fanxiaohui/SmartCar/PCB资料/鹰眼管脚说明.pdf

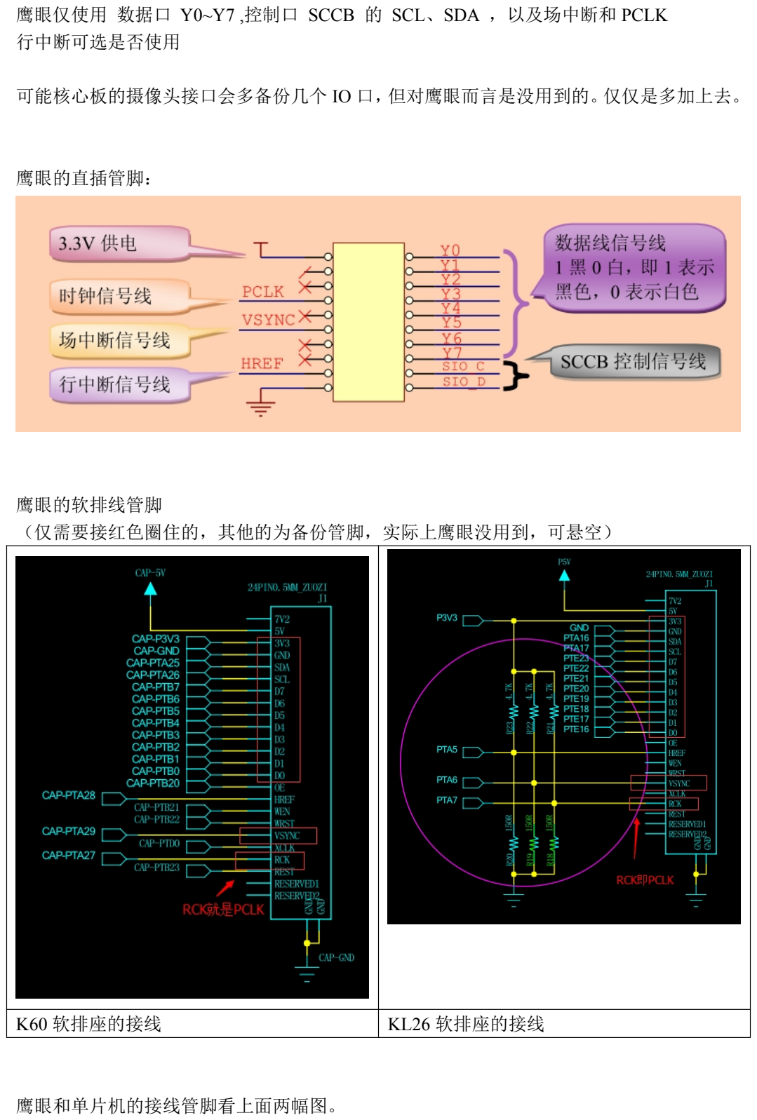
[picture p71: page 1]

鹰眼仅使用 数据口 Y0~Y7 ,控制口 SCCB 的 SCL、SDA ，以及场中断和 PCLK 行中断可选是否使用

可能核心板的摄像头接口会多备份几个 IO 口，但对鹰眼而言是没用到的。仅仅是多加上去。

鹰眼的直插管脚：

鹰眼的软排线管脚
（仅需要接红色圈住的，其他的为备份管脚，实际上鹰眼没用到，可悬空）
K60 软排座的接线 | KL26 软排座的接线

鹰眼和单片机的接线管脚看上面两幅图。
