fanxiaohui/SmartCar/十二届光电追逐组程序（附说明，一点资料）/逆透视变换的一种方法.pdf

# www.znczz.com

# 逆透视变换的一种方法

朱葛峻

2015年12月

## 1 写这篇文章的原因

前段时间有人问了我这篇帖子（[分享] 好久没有人发技术贴了，来个透视变 换与其逆变换的矩阵公式，打打鸡血），文中的方法很有道理，但却很复杂。 (http://www.znczz.com/thread-119033-1-1.html) 于是我想把我的方法写出来。

## 2 数学模型

小孔摄像机数学模型：

s

x
y
1
- =
fx | 0 | cx
0 | fy | cy
0 | 0 | 1
r11 | r12 | r13 | t1
r21 | r22 | r23 | t2
r31 | r32 | r33 | t3

X
Y
Z
1

针对以上模型，我们可以归纳为：

s · m⁰ = A · [R|t] · M⁰

其中s是倍乘因子，m⁰指图像坐标系，M⁰指世界坐标系，[R|t]指线性变换矩 阵，A指相机内参数矩阵。

## 3 对于模型的一点解释

s · m⁰这个就是我们通常程序中对图像的贮存，即获得的二维数组，当然也 有些同学用一维数组表示。也许以后有同学能设计出一个数据结构呢。 A内参数矩阵的意义是，将相机坐标系转换为像平面坐标系，可以这么想 像，将一幅本来存在于芯片镜面上的图像转换为我们脑海里的数组。其实就是 转换坐标系，图像一开始在芯片以毫米英寸为单位，现在转换为以一个像素为 单位了。其实就像可以描述一个人为一米八，也可以描述为为九头身。 [R|t]就是我们所说的线性变换矩阵。关于这里的知识可以访问百度文库里 的这篇演示文档：图像处理之逆透视变换。 (http://wenku.baidu.com/link)
M’就是世界坐标系了。

1

# www.znczz.com

### 4 应用

这个公式源自张正友先生的论文，opencv里也有引用。这里讲下在飞思卡 尔智能车的应用下的方式。
首先，一般智能车选择的是单目摄像头且不存在测距模块，无法获得一副图 像的深度图，那么自然而然，Z=0。

s

x
y
1
- =
fx | 0 | cx
0 | fy | cy
0 | 0 | 1
r11 | r12 | r13 | t1
r21 | r22 | r23 | t2
r31 | r32 | r33 | t3

X
Y
0
1

let H =

fx | 0 | cx
0 | fy | cy
0 | 0 | 1
r11 | r12 | r13 | t1
r21 | r22 | r23 | t2
r31 | r32 | r33 | t3

and H34 =

H11 | H12 | Don⁰
tCare H13
H21 | H22 | Don⁰
tCare H23
H31 | H32 | Don⁰
tCare | 1

又因为H33可以归纳为s的一部分，即可得到最终我们需要的一个表达式。

x
y
s
- =
H11 | H12 | H13
H21 | H22 | H23
H31 | H32 | 1

X
Y
1

### 5 演算

直到这里，这些都依旧是难以使用的东西。

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
然后就可以得到

x =

XH11 + Y H12 + H13
XH31 + Y H32 + 1

(3)

y =

XH21 + Y H22 + H23
XH31 + Y H32 + 1

(4)

xXH31 + xY H32 + x − XH11 − Y H12 − H13 = 0 | (5)
yXH31 + yY H32 + y − XH21 − Y H22 − H23 = 0 | (6)

2

# www.znczz.com

X Y 1 | 0 | 0 | 0 −xX −xY
0 | 0 | 0 X Y 1 −yX | −yY

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
→ A · X = B
学过线性代数的我们知道，要有唯一解，需要保证增广矩阵为满秩， 即rank(A|B) = 8。那么就需要四组不相关的图像坐标系的点。由于世界坐 标系的点在标定的时候，我们是知道的。那么我们可以选择一个矩形的四个顶 点，将之代入上式即可。

## 6 代码实现

具体代码实现在我以前的帖子里就有，这里我也不再赘述。逆透视变换的代 码。总之就一句话，保证全局有解再去追求迭代的快速。 (http://www.znczz.com/thread-236861-1-1.html)

3
