fanxiaohui/SmartCar/PCB资料/液晶引脚定义.png

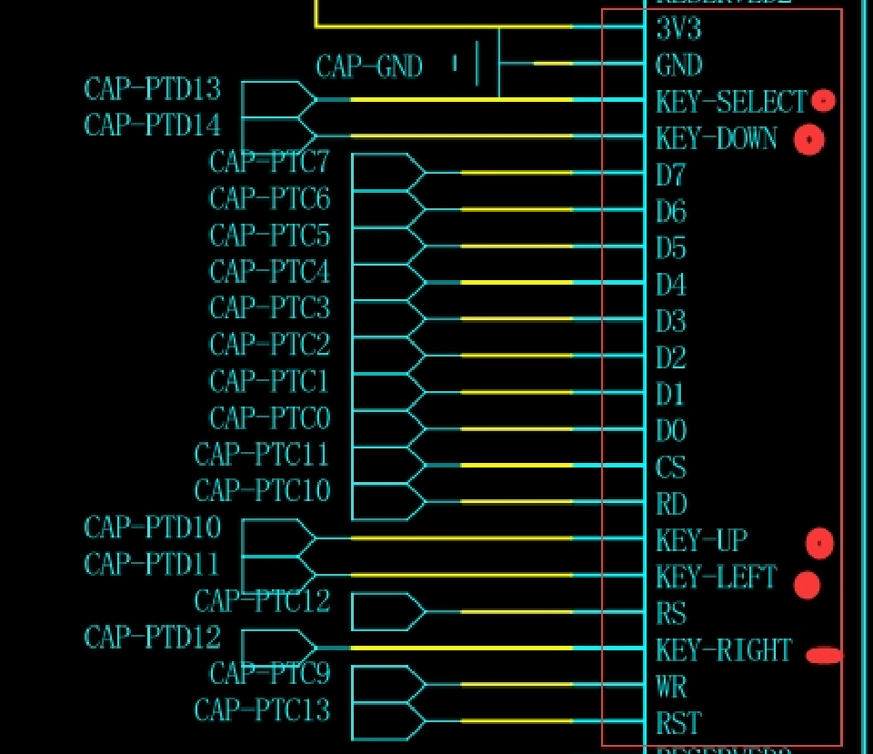
PCB资料/液晶引脚定义.png
