fanxiaohui/SmartCar/PCB资料/编码器引脚定义.png

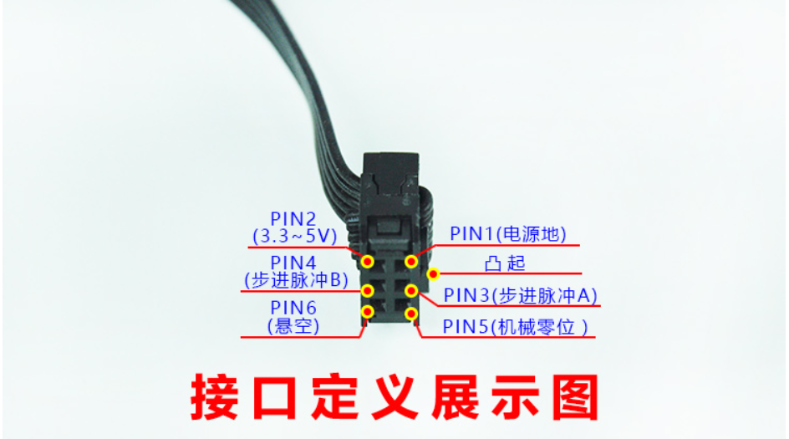
PCB资料/编码器引脚定义.png
