fanxiaohui/SmartCar/PCB资料/龙邱k60/LQ-KXXP144-SYSVG丝印标号.PNG

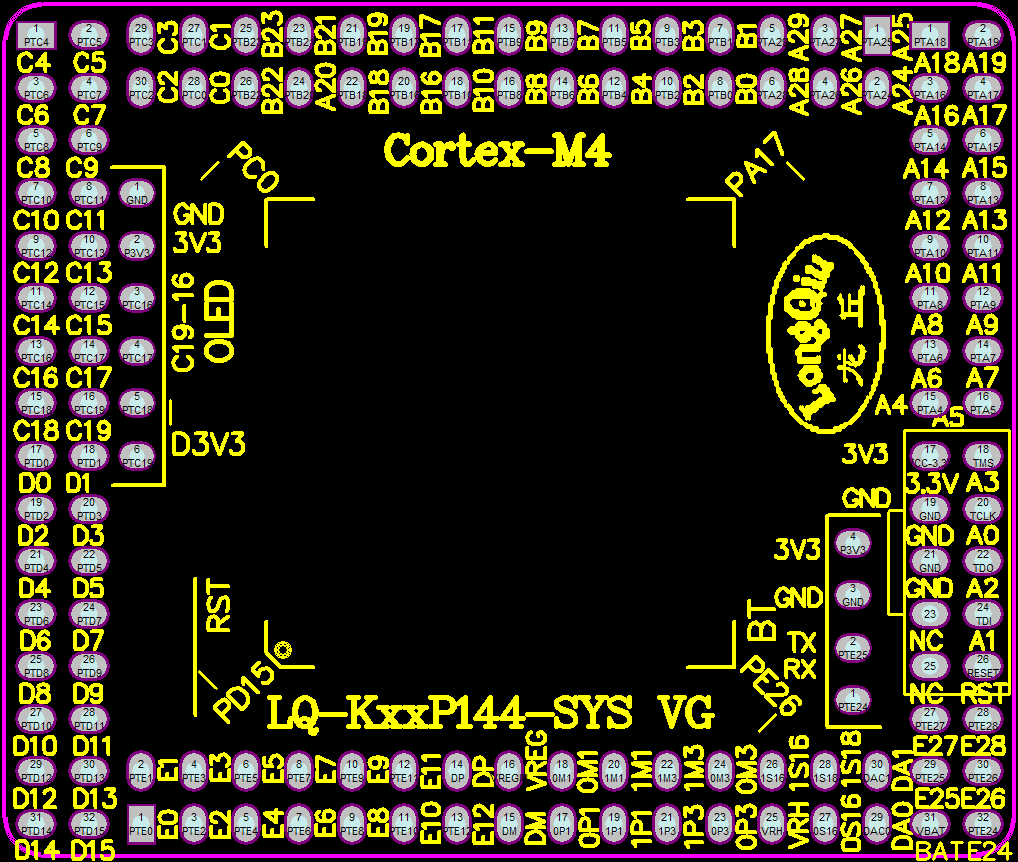
PCB资料/龙邱k60/LQ-KXXP144-SYSVG丝印标号.PNG
