fanxiaohui/SmartCar/PCB资料/龙邱k60/LQ-K60P144-SYSVG核心板原理图.pdf

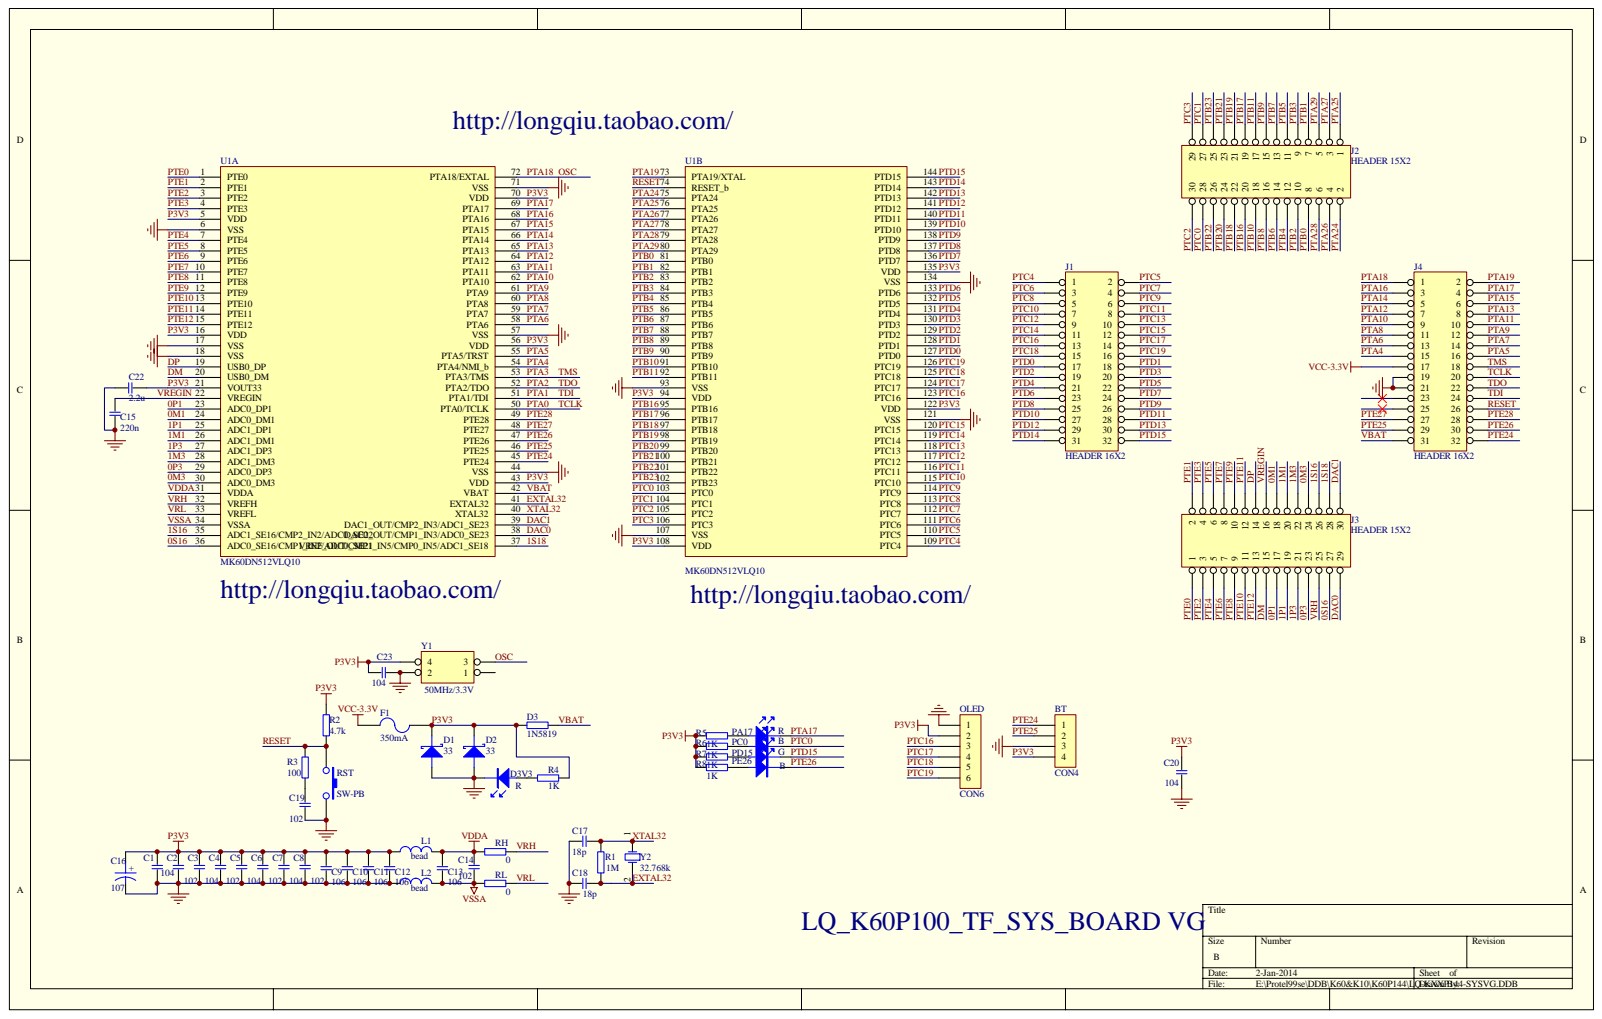
[picture p75: page 1]

http://longqiu.taobao.com/

PTA24 PTA25 DAC0 DAC1 VBAT PTE24 PTE25 PTE26 PTE27 PTE28 RESET TMS TDO TDI TCLK PTA4 PTA5 PTA6 PTA7 PTA8 PTA9 PTA10 PTA11 PTA12 PTA13 PTA14 PTA15 PTA16 PTA17 PTA18 PTA19

PTA2 | | | PTC17

VREGIN | VREGIN 22 | PTA1 | P3V3 | PTC16

Size B | Number | Revision

Date: 2-Jan-2014 | Sheet of
File: E:\Protel99se\DDB\K60&K10\K60P144\LQ-Drawn By: KXXP144-SYSVG.DDB
