fanxiaohui/SmartCar/(list of files, drawings)

Other design files:
PCB资料/光电追逐组-第十二届PCB图/3主板电路/A车主板模版.PcbDoc
PCB资料/光电追逐组-第十二届PCB图/3主板电路/主板PCB第3次/主板PCB第3次.PcbDoc
PCB资料/光电追逐组-第十二届PCB图/3主板电路/主板PCB第3次/主板PCB第3次.PrjPcb
PCB资料/光电追逐组-第十二届PCB图/3主板电路/主板PCB第3次/主板原理图第3次.SchDoc
PCB资料/光电追逐组-第十二届PCB图/4驱动电路/驱动PCB模型2.PcbDoc
PCB资料/光电追逐组-第十二届PCB图/4驱动电路/驱动PCB模型.PcbDoc
PCB资料/光电追逐组-第十二届PCB图/4驱动电路/驱动PCB第4次/驱动PCB第4次.PcbDoc
PCB资料/光电追逐组-第十二届PCB图/4驱动电路/驱动PCB第4次/驱动PCB第4次.PrjPcb
PCB资料/光电追逐组-第十二届PCB图/4驱动电路/驱动PCB第4次/驱动PCB第4次.SchDoc
PCB资料/光电追逐组-第十二届PCB图/连接板/摄像头转接板/摄像头转接板PCB.PcbDoc
PCB资料/光电追逐组-第十二届PCB图/连接板/摄像头转接板/摄像头转接板PCB.PrjPcb
PCB资料/光电追逐组-第十二届PCB图/连接板/摄像头转接板/摄像头转接板原理图.SchDoc
PCB资料/光电追逐组-第十二届PCB图/连接板/编码器固定板/mini编码器固定板1型.PcbDoc
PCB资料/光电追逐组-第十二届PCB图/连接板/编码器固定板/mini编码器固定板2型.PcbDoc
PCB资料/光电追逐组-第十二届PCB图/连接板/编码器固定板/mini编码器固定板3型.PcbDoc
PCB资料/光电追逐组-第十二届PCB图/连接板/编码器固定板/mini编码器固定板4型.PcbDoc
PCB资料/光电追逐组-第十二届PCB图/连接板/舵机/A车卧式舵机支架.PcbDoc
PCB资料/光电追逐组-第十二届PCB图/连接板/舵机/舵机摆臂-卧式35mm.PcbDoc
PCB资料/光电追逐组-第十二届PCB图/连接板/舵机/舵机摆臂-立式24mm.PcbDoc
PCB资料/光电追逐组-第十二届PCB图/连接板/舵机/舵机摆臂-立式27mm.PcbDoc
PCB资料/光电追逐组-第十二届PCB图/连接板/舵机/舵机摆臂-立式30mm.PcbDoc
PCB资料/光电追逐组-第十二届PCB图/连接板/舵机/舵机摆臂-立式33mm.PcbDoc
PCB资料/光电追逐组-第十二届PCB图/连接板/车身连接板/A车模连接板1型.PcbDoc
PCB资料/光电追逐组-第十二届PCB图/连接板/车身连接板/A车模连接板2型.PcbDoc
PCB资料/光电追逐组-第十二届PCB图/连接板/车身连接板/旧C车模连接板.PcbDoc
PCB资料/第一次打板.PcbDoc
PCB资料/龙邱k60/LQ_KXXP144-SYSVGPCB.PCBLIB
PCB资料/龙邱k60/LQ_KXXP144-SYSVGSCH.SCHLIB
