fanxiaohui/SmartCar/十二届光电追逐组程序（附说明，一点资料）/国赛826-A车/Chip/src/MK60_flash.c

/*!
 *     COPYRIGHT NOTICE
 *     Copyright (c) 2013,山外科技
 *     All rights reserved.
 *     技术讨论：山外论坛 http://www.vcan123.com
 *
 *     除注明出处外，以下所有内容版权均属山外科技所有，未经允许，不得用于商业用途，
 *     修改内容时必须保留山外科技的版权声明。
 *
 * @file       MK60_flash.c
 * @brief      flash函数库
 * @author     山外科技
 * @version    v5.2
 * @date       2014-10-09
 */


//包含头文件

#include "MK60_flash.h"

//宏定义 FCCOB Number
#if defined(MK60DZ10)
#define     FCMD        FTFL_FCCOB0         //FTFL 命令

#define     FADDR2      FTFL_FCCOB1         //Flash address [23:16]
#define     FADDR1      FTFL_FCCOB2         //Flash address [15:8]
#define     FADDR0      FTFL_FCCOB3         //Flash address [7:0]

#define     FDATA0      FTFL_FCCOB4         //Data Byte 0       //注意一点，4字节排序，FDATA3是最低位，FDATA0是最高位
#define     FDATA1      FTFL_FCCOB5         //Data Byte 1
#define     FDATA2      FTFL_FCCOB6         //Data Byte 2
#define     FDATA3      FTFL_FCCOB7         //Data Byte 3
#define     FDATA4      FTFL_FCCOB8         //Data Byte 4
#define     FDATA5      FTFL_FCCOB9         //Data Byte 5
#define     FDATA6      FTFL_FCCOBA         //Data Byte 6
#define     FDATA7      FTFL_FCCOBB         //Data Byte 7

//FCMD 命令
#define     RD1BLK    0x00   // 读整块Flash
#define     RD1SEC    0x01   // 读整个扇区
#define     PGMCHK    0x02   // 写入检查
#define     RDRSRC    0x03   // 读目标数据(4字节)
#define     PGM4      0x06   // 写入长字(4字节)
#define     ERSBLK    0x08   // 擦除整块Flash
#define     ERSSCR    0x09   // 擦除Flash扇区
#define     PGMSEC    0x0B   // 写入扇区
#define     RD1ALL    0x40   // 读所有的块
#define     RDONCE    0x41   // 只读一次
#define     PGMONCE   0x43   // 只写一次
#define     ERSALL    0x44   // 擦除所有块
#define     VFYKEY    0x45   // 验证后门访问钥匙
#define     PGMPART   0x80   // 写入分区
#define     SETRAM    0x81   // 设定FlexRAM功能

#elif defined(MK60F15)
#define     FCMD        FTFE_FCCOB0         //FTFL 命令

#define     FADDR2      FTFE_FCCOB1         //Flash address [23:16]
#define     FADDR1      FTFE_FCCOB2         //Flash address [15:8]
#define     FADDR0      FTFE_FCCOB3         //Flash address [7:0]
//Must be 64-bit aligned (Flash address [2:0] = 000)  8字节对齐

#define     FDATA0      FTFE_FCCOB4         //Data Byte 0       //注意一点，4字节排序，FDATA3是最低位，FDATA0是最高位
#define     FDATA1      FTFE_FCCOB5         //Data Byte 1
#define     FDATA2      FTFE_FCCOB6         //Data Byte 2
#define     FDATA3      FTFE_FCCOB7         //Data Byte 3
#define     FDATA4      FTFE_FCCOB8         //Data Byte 4
#define     FDATA5      FTFE_FCCOB9         //Data Byte 5
#define     FDATA6      FTFE_FCCOBA         //Data Byte 6
#define     FDATA7      FTFE_FCCOBB         //Data Byte 7

//FCMD 命令
#define     RD1BLK    0x00   // 读整块Flash
#define     RD1SEC    0x01   // 读整个扇区
#define     PGMCHK    0x02   // 写入检查
#define     RDRSRC    0x03   // 读目标数据(8字节)
#define     PGM8      0x07   // 写入长字(8字节)
#define     ERSBLK    0x08   // 擦除整块Flash
#define     ERSSCR    0x09   // 擦除Flash扇区
#define     PGMSEC    0x0B   // 写入扇区
#define     RD1ALL    0x40   // 读所有的块
#define     RDONCE    0x41   // 只读一次
#define     PGMONCE   0x43   // 只写一次
#define     ERSALL    0x44   // 擦除所有块
#define     VFYKEY    0x45   // 验证后门访问钥匙
#define     PGMPART   0x80   // 写入分区
#define     SETRAM    0x81   // 设定FlexRAM功能

#endif



/*!
 *  @brief      Flash命令
 *  @return     命令执行结果(1成功，0失败)
 *  @since      v5.0
 */
__RAMFUNC uint8 flash_cmd()
{
    //写 FTFL_FSTAT 启动 Flash命令
#if defined(MK60DZ10)
    FTFL_FSTAT =    (0
                     |  FTFL_FSTAT_CCIF_MASK        // 指令完成标志(写1清0)
                     |  FTFL_FSTAT_RDCOLERR_MASK    // 读冲突错误标志(写1清0)
                     |  FTFL_FSTAT_ACCERR_MASK      // 访问错误标志位(写1清0)
                     |  FTFL_FSTAT_FPVIOL_MASK      // 非法访问保护标志位(写1清0)
                    );

    while(!(FTFL_FSTAT & FTFL_FSTAT_CCIF_MASK));    // 等待命令完成

    // 检查错误标志
    if( FTFL_FSTAT & (FTFL_FSTAT_ACCERR_MASK | FTFL_FSTAT_RDCOLERR_MASK | FTFL_FSTAT_FPVIOL_MASK | FTFL_FSTAT_MGSTAT0_MASK))
    {
        return 0 ;                                  //执行命令出错
    }
    else
    {
        return 1;                                   //执行命令成功
    }

#elif defined(MK60F15)
    FTFE_FSTAT =    (0
                     |  FTFE_FSTAT_CCIF_MASK        // 指令完成标志(写1清0)
                     |  FTFE_FSTAT_RDCOLERR_MASK    // 读冲突错误标志(写1清0)
                     |  FTFE_FSTAT_ACCERR_MASK      // 访问错误标志位(写1清0)
                     |  FTFE_FSTAT_FPVIOL_MASK      // 非法访问保护标志位(写1清0)
                    );

    while(!(FTFE_FSTAT & FTFE_FSTAT_CCIF_MASK));    // 等待命令完成

    // 检查错误标志
    if( FTFE_FSTAT & (FTFE_FSTAT_ACCERR_MASK | FTFE_FSTAT_RDCOLERR_MASK | FTFE_FSTAT_FPVIOL_MASK | FTFE_FSTAT_MGSTAT0_MASK))
    {
        return 0 ;                                  //执行命令出错
    }
    else
    {
        return 1;                                   //执行命令成功
    }

#endif
}


/*!
 *  @brief      初始化flash
 *  @since      v5.0
 */
__RAMFUNC void flash_init(void)
{
#if defined( MK60DZ10)
    // 清除Flash预读取缓冲区
    FMC_PFB0CR |= FMC_PFB0CR_S_B_INV_MASK;      //
    FMC_PFB1CR |= FMC_PFB0CR_S_B_INV_MASK;

    while(!(FTFL_FSTAT & FTFL_FSTAT_CCIF_MASK));    // 等待命令完成

    FTFL_FSTAT =    (0
                     |  FTFL_FSTAT_CCIF_MASK        // 指令完成标志(写1清0)
                     |  FTFL_FSTAT_RDCOLERR_MASK    // 读冲突错误标志(写1清0)
                     |  FTFL_FSTAT_ACCERR_MASK      // 访问错误标志位(写1清0)
                     |  FTFL_FSTAT_FPVIOL_MASK      // 非法访问保护标志位(写1清0)
                    );

#elif defined(MK60F15)
    // 清除Flash预读取缓冲区
    FMC_PFB01CR |= FMC_PFB01CR_S_B_INV_MASK;      //
    //FMC_PFB23CR |= FMC_PFB23CR_S_B_INV_MASK;

    while(!(FTFE_FSTAT & FTFE_FSTAT_CCIF_MASK));    // 等待命令完成

    FTFE_FSTAT =    (0
                     |  FTFE_FSTAT_CCIF_MASK        // 指令完成标志(写1清0)
                     |  FTFE_FSTAT_RDCOLERR_MASK    // 读冲突错误标志(写1清0)
                     |  FTFE_FSTAT_ACCERR_MASK      // 访问错误标志位(写1清0)
                     |  FTFE_FSTAT_FPVIOL_MASK      // 非法访问保护标志位(写1清0)
                    );
#endif
    DELAY_MS(10);
}

/*!
 *  @brief      擦除指定flash扇区
 *  @param      sector_num    扇区号（K60N512实际使用0~255）
 *  @return     执行结果(1成功，0失败)
 *  @since      v5.0
 *  Sample usage:       flash_erase_sector(127);        //擦除扇区127
 */
__RAMFUNC uint8 flash_erase_sector(uint16 sector_num)
{
    uint32 addr = sector_num * FLASH_SECTOR_SIZE;

    // 设置擦除命令
    FCMD = ERSSCR;

    // 设置目标地址
    FADDR2 = ((Dtype *)&addr)->B[2];
    FADDR1 = ((Dtype *)&addr)->B[1];
    FADDR0 = ((Dtype *)&addr)->B[0];

    if(flash_cmd() == 0)
    {
        return 0;
    }

    if(sector_num == 0)
    {
#if defined(MK60DZ10)
        return flash_write(sector_num,0x00040C,0xFFFFFFFE);
#elif defined(MK60F15)
        return flash_write(sector_num,0x000408,0xFFFFFFFEFFFFFFFF );
#endif
    }

    return 1;
}


/*!
 *  @brief      写入长字节数据到 flash指定地址
 *  @param      sector_num      扇区号（0 ~ FLASH_SECTOR_NUM）
 *  @param      offset          写入扇区内部偏移地址（0~2043 中 4的倍数）
 *  @param      data            需要写入的数据
 *  @return     执行结果(1成功，0失败)
 *  @since      v5.0
 *  Sample usage:       flash_write(127,0,0xFFFFFFFE);        //扇区127,偏移地址为0,写入数据:0xFFFFFFFE
 */
__RAMFUNC uint8 flash_write(uint16 sector_num, uint16 offset, FLASH_WRITE_TYPE data)
{
    uint32 addr = sector_num * FLASH_SECTOR_SIZE  + offset ;
    uint32 tmpdata;

    ASSERT(offset % FLASH_ALIGN_ADDR == 0);             //偏移量必须为4的倍数
    //此处提示警告，但是安全的……
    ASSERT(offset <= FLASH_SECTOR_SIZE);                //扇区大小为2K，即偏移量必须不大于 0x800
    //此处提示警告，但是安全的……

    // 设置目标地址
    FADDR2 = ((Dtype *)&addr)->B[2];
    FADDR1 = ((Dtype *)&addr)->B[1];
    FADDR0 = ((Dtype *)&addr)->B[0];

    // 设置 低32位数据
    tmpdata = (uint32)data;

    FDATA0 = ((Dtype *)&tmpdata)->B[3];                    // 设置写入数据
    FDATA1 = ((Dtype *)&tmpdata)->B[2];
    FDATA2 = ((Dtype *)&tmpdata)->B[1];
    FDATA3 = ((Dtype *)&tmpdata)->B[0];

#if defined(MK60DZ10)

    // 设置擦除命令
    FCMD = PGM4;

#elif defined(MK60F15)

    // 设置擦除命令
    FCMD = PGM8;

    // 设置 高32位数据
    tmpdata = (uint32)(data>>32);

    FDATA4 = ((Dtype *)&tmpdata)->B[3];                 // 设置写入数据
    FDATA5 = ((Dtype *)&tmpdata)->B[2];
    FDATA6 = ((Dtype *)&tmpdata)->B[1];
    FDATA7 = ((Dtype *)&tmpdata)->B[0];
#endif

    if(flash_cmd() == 0)
    {
        return 0;
    }

    return 1;  //成功执行

}


/*!
 *  @brief      写入数据缓冲区到 flash指定地址
 *  @param      sector_num      扇区号（K60N512实际使用0~255）
 *  @param      offset          写入扇区内部偏移地址（0~2043 中 4的倍数）
 *  @param      buf             需要写入的数据缓冲区首地址
 *  @return     执行结果(1成功，0失败)
 *  @since      v5.0
 *  Sample usage:           uint32 buff[10];
                            flash_write_buf(127,0,sizeof(buff),buff);        //扇区127,偏移地址为0,写入数据源地址:buff,数目sizeof(buff)
 */

__RAMFUNC uint8 flash_write_buf(uint16 sector_num, uint16 offset, uint16 cnt, uint8 *buf)
{
    uint32  size;

    uint32  addr;
    uint32  data;

    ASSERT(offset % FLASH_ALIGN_ADDR == 0);                    //偏移量必须为4的倍数
    //此处提示警告，但是安全的(ram函数调用rom函数引起警告)
    ASSERT(offset <= FLASH_SECTOR_SIZE );                    //扇区大小为2K，即偏移量必须不大于 0x800
    //此处提示警告，但是安全的(ram函数调用rom函数引起警告)

    addr = sector_num * FLASH_SECTOR_SIZE  + offset;      //计算地址

    // 设置写入命令
#if defined(MK60DZ10)
    FCMD = PGM4;
#elif defined(MK60F15)
    FCMD = PGM8;
#endif

    for(size = 0; size < cnt; size += FLASH_ALIGN_ADDR )
    {

        // 设置目标地址
        FADDR2 = ((Dtype *)&addr)->B[2];
        FADDR1 = ((Dtype *)&addr)->B[1];
        FADDR0 = ((Dtype *)&addr)->B[0];

        // 设置 低32位数据
        data =  *(uint32 *)buf;

        FDATA0 = ((Dtype *)&data)->B[3];                    // 设置写入数据
        FDATA1 = ((Dtype *)&data)->B[2];
        FDATA2 = ((Dtype *)&data)->B[1];
        FDATA3 = ((Dtype *)&data)->B[0];

#if defined(MK60F15)
        // 设置 高32位数据
        data = *(uint32 *)(buf+4);

        FDATA4 = ((Dtype *)&data)->B[3];                    // 设置写入数据
        FDATA5 = ((Dtype *)&data)->B[2];
        FDATA6 = ((Dtype *)&data)->B[1];
        FDATA7 = ((Dtype *)&data)->B[0];
#endif

        if(flash_cmd() == 0)
        {
            return 0;
        }

        addr += FLASH_ALIGN_ADDR;
        buf += FLASH_ALIGN_ADDR;
    }
    return 1;  //成功执行
}
