fanxiaohui/SmartCar/十二届光电追逐组程序（附说明，一点资料）/国赛826-A车/Chip/inc/MK60_gpio_cfg.h

/*!
 *     COPYRIGHT NOTICE
 *     Copyright (c) 2013,山外科技
 *     All rights reserved.
 *     技术讨论：山外论坛 http://www.vcan123.com
 *
 *     除注明出处外，以下所有内容版权均属山外科技所有，未经允许，不得用于商业用途，
 *     修改内容时必须保留山外科技的版权声明。
 *
 * @file       MK60_gpio_cfg.h
 * @brief      gpio的端口定义头文件
 * @author     山外
 * @version    v5.1
 * @date       2014-04-25
 */
#ifndef __MK60_GPIO_CFG_H__
#define __MK60_GPIO_CFG_H__


#if 1       //寄存器位操作，有两种方法，前者效率更高，因而此处使用第一种
#define PT(X,n,REG)         BITBAND_REG(PT##X##_BASE_PTR->##REG,n)              //位操作
#else
#define PT(X,n,REG)         (((Dtype *)(&(PT##X##_BASE_PTR->##REG)))->b##n)
#endif

#define PT_BYTE(X,n,REG)    (((Dtype *)(&(PT##X##_BASE_PTR->##REG)))->B[n])
#define PT_WORD(X,n,REG)    (((Dtype *)(&(PT##X##_BASE_PTR->##REG)))->W[n])
#define PT_DWORD(X,REG)     (((Dtype *)(&(PT##X##_BASE_PTR->##REG)))->DW)
/* Sample usage:
PT_BYTE(A,0,PDOR)  =   (((Dtype *)(&(PTA_BASE_PTR->PDOR)))->B[0])

## ，一般用于把两个宏参数贴合在一起，
这里把 PT A  _BASE_PTR-> PDOR ->B[0] 串接起来

*/

//1位操作
#define     _PTXn_T(ptxn,type)   (ptxn##_##type)
#define     PTXn_T(ptxn,type)    _PTXn_T(ptxn,type)

//8位操作
#define     _PTX_Bn_T(ptx,n,type)  (ptx##_B##n##_##type)
#define     PTX_Bn_T(ptx,n,type)   _PTX_Bn_T(ptx,n,type)

//16位操作
#define     _PTX_Wn_T(ptx,n,type)  (ptx##_W##n##_##type)
#define     PTX_Wn_T(ptx,n,type)   _PTX_Wn_T(ptx,n,type)

//32位操作
#define     _PTX_T(ptx,type)  (ptx##_##type)
#define     PTX_T(ptx,type)   _PTX_T(ptx,type)


//定义PTA的端口
#define PTA0_OUT            PT(A,0,PDOR)
#define PTA1_OUT            PT(A,1,PDOR)
#define PTA2_OUT            PT(A,2,PDOR)
#define PTA3_OUT            PT(A,3,PDOR)
#define PTA4_OUT            PT(A,4,PDOR)
#define PTA5_OUT            PT(A,5,PDOR)
#define PTA6_OUT            PT(A,6,PDOR)
#define PTA7_OUT            PT(A,7,PDOR)
#define PTA8_OUT            PT(A,8,PDOR)
#define PTA9_OUT            PT(A,9,PDOR)
#define PTA10_OUT           PT(A,10,PDOR)
#define PTA11_OUT           PT(A,11,PDOR)
#define PTA12_OUT           PT(A,12,PDOR)
#define PTA13_OUT           PT(A,13,PDOR)
#define PTA14_OUT           PT(A,14,PDOR)
#define PTA15_OUT           PT(A,15,PDOR)
#define PTA16_OUT           PT(A,16,PDOR)
#define PTA17_OUT           PT(A,17,PDOR)
#define PTA18_OUT           PT(A,18,PDOR)
#define PTA19_OUT           PT(A,19,PDOR)
#define PTA20_OUT           PT(A,20,PDOR)
#define PTA21_OUT           PT(A,21,PDOR)
#define PTA22_OUT           PT(A,22,PDOR)
#define PTA23_OUT           PT(A,23,PDOR)
#define PTA24_OUT           PT(A,24,PDOR)
#define PTA25_OUT           PT(A,25,PDOR)
#define PTA26_OUT           PT(A,26,PDOR)
#define PTA27_OUT           PT(A,27,PDOR)
#define PTA28_OUT           PT(A,28,PDOR)
#define PTA29_OUT           PT(A,29,PDOR)
#define PTA30_OUT           PT(A,30,PDOR)
#define PTA31_OUT           PT(A,31,PDOR)

//定义PTB的端口
#define PTB0_OUT           PT(B,0,PDOR)
#define PTB1_OUT           PT(B,1,PDOR)
#define PTB2_OUT           PT(B,2,PDOR)
#define PTB3_OUT           PT(B,3,PDOR)
#define PTB4_OUT           PT(B,4,PDOR)
#define PTB5_OUT           PT(B,5,PDOR)
#define PTB6_OUT           PT(B,6,PDOR)
#define PTB7_OUT           PT(B,7,PDOR)
#define PTB8_OUT           PT(B,8,PDOR)
#define PTB9_OUT           PT(B,9,PDOR)
#define PTB10_OUT           PT(B,10,PDOR)
#define PTB11_OUT           PT(B,11,PDOR)
#define PTB12_OUT           PT(B,12,PDOR)
#define PTB13_OUT           PT(B,13,PDOR)
#define PTB14_OUT           PT(B,14,PDOR)
#define PTB15_OUT           PT(B,15,PDOR)
#define PTB16_OUT           PT(B,16,PDOR)
#define PTB17_OUT           PT(B,17,PDOR)
#define PTB18_OUT           PT(B,18,PDOR)
#define PTB19_OUT           PT(B,19,PDOR)
#define PTB20_OUT           PT(B,20,PDOR)
#define PTB21_OUT           PT(B,21,PDOR)
#define PTB22_OUT           PT(B,22,PDOR)
#define PTB23_OUT           PT(B,23,PDOR)
#define PTB24_OUT           PT(B,24,PDOR)
#define PTB25_OUT           PT(B,25,PDOR)
#define PTB26_OUT           PT(B,26,PDOR)
#define PTB27_OUT           PT(B,27,PDOR)
#define PTB28_OUT           PT(B,28,PDOR)
#define PTB29_OUT           PT(B,29,PDOR)
#define PTB30_OUT           PT(B,30,PDOR)
#define PTB31_OUT           PT(B,31,PDOR)

//定义PTC的端口
#define PTC0_OUT           PT(C,0,PDOR)
#define PTC1_OUT           PT(C,1,PDOR)
#define PTC2_OUT           PT(C,2,PDOR)
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
#define PTB_B2_DDR        PT_BYTE(B,2,PDDR)
#define PTB_B3_DDR        PT_BYTE(B,3,PDDR)


//定义PTC的8位输出输入方向端口
#define PTC_B0_DDR        PT_BYTE(C,0,PDDR)
#define PTC_B1_DDR        PT_BYTE(C,1,PDDR)
#define PTC_B2_DDR        PT_BYTE(C,2,PDDR)
#define PTC_B3_DDR        PT_BYTE(C,3,PDDR)

//定义PTD的8位输出输入方向端口
#define PTD_B0_DDR        PT_BYTE(D,0,PDDR)
#define PTD_B1_DDR        PT_BYTE(D,1,PDDR)
#define PTD_B2_DDR        PT_BYTE(D,2,PDDR)
#define PTD_B3_DDR        PT_BYTE(D,3,PDDR)

//定义PTE的8位输出输入方向端口
#define PTE_B0_DDR        PT_BYTE(E,0,PDDR)
#define PTE_B1_DDR        PT_BYTE(E,1,PDDR)
#define PTE_B2_DDR        PT_BYTE(E,2,PDDR)
#define PTE_B3_DDR        PT_BYTE(E,3,PDDR)



//定义PTA的8位输入端口
#define PTA_B0_IN        PT_BYTE(A,0,PDIR)
#define PTA_B1_IN        PT_BYTE(A,1,PDIR)
#define PTA_B2_IN        PT_BYTE(A,2,PDIR)
#define PTA_B3_IN        PT_BYTE(A,3,PDIR)

//定义PTB的8位输入端口
#define PTB_B0_IN        PT_BYTE(B,0,PDIR)
#define PTB_B1_IN        PT_BYTE(B,1,PDIR)
#define PTB_B2_IN        PT_BYTE(B,2,PDIR)
#define PTB_B3_IN        PT_BYTE(B,3,PDIR)


//定义PTC的8位输入端口
#define PTC_B0_IN        PT_BYTE(C,0,PDIR)
#define PTC_B1_IN        PT_BYTE(C,1,PDIR)
#define PTC_B2_IN        PT_BYTE(C,2,PDIR)
#define PTC_B3_IN        PT_BYTE(C,3,PDIR)

//定义PTD的8位输入端口
#define PTD_B0_IN        PT_BYTE(D,0,PDIR)
#define PTD_B1_IN        PT_BYTE(D,1,PDIR)
#define PTD_B2_IN        PT_BYTE(D,2,PDIR)
#define PTD_B3_IN        PT_BYTE(D,3,PDIR)

//定义PTE的8位输入端口
#define PTE_B0_IN        PT_BYTE(E,0,PDIR)
#define PTE_B1_IN        PT_BYTE(E,1,PDIR)
#define PTE_B2_IN        PT_BYTE(E,2,PDIR)
#define PTE_B3_IN        PT_BYTE(E,3,PDIR)


//定义PTA的8位输出反转
#define PTA_B0_T        PT_BYTE(A,0,PTOR)
#define PTA_B1_T        PT_BYTE(A,1,PTOR)
#define PTA_B2_T        PT_BYTE(A,2,PTOR)
#define PTA_B3_T        PT_BYTE(A,3,PTOR)

//定义PTB的8位输出反转
#define PTB_B0_T        PT_BYTE(B,0,PTOR)
#define PTB_B1_T        PT_BYTE(B,1,PTOR)
#define PTB_B2_T        PT_BYTE(B,2,PTOR)
#define PTB_B3_T        PT_BYTE(B,3,PTOR)


//定义PTC的8位输出反转
#define PTC_B0_T        PT_BYTE(C,0,PTOR)
#define PTC_B1_T        PT_BYTE(C,1,PTOR)
#define PTC_B2_T        PT_BYTE(C,2,PTOR)
#define PTC_B3_T        PT_BYTE(C,3,PTOR)

//定义PTD的8位输出反转
#define PTD_B0_T        PT_BYTE(D,0,PTOR)
#define PTD_B1_T        PT_BYTE(D,1,PTOR)
#define PTD_B2_T        PT_BYTE(D,2,PTOR)
#define PTD_B3_T        PT_BYTE(D,3,PTOR)

//定义PTE的8位输出反转
#define PTE_B0_T        PT_BYTE(E,0,PTOR)
#define PTE_B1_T        PT_BYTE(E,1,PTOR)
#define PTE_B2_T        PT_BYTE(E,2,PTOR)
#define PTE_B3_T        PT_BYTE(E,3,PTOR)


//定义PTA的16位端口
#define PTA_W0_OUT        PT_WORD(A,0,PDOR)
#define PTA_W1_OUT        PT_WORD(A,1,PDOR)

//定义PTB的16位端口
#define PTB_W0_OUT        PT_WORD(B,0,PDOR)
#define PTB_W1_OUT        PT_WORD(B,1,PDOR)

//定义PTC的16位端口
#define PTC_W0_OUT        PT_WORD(C,0,PDOR)
#define PTC_W1_OUT        PT_WORD(C,1,PDOR)


//定义PTD的16位端口
#define PTD_W0_OUT        PT_WORD(D,0,PDOR)
#define PTD_W1_OUT        PT_WORD(D,1,PDOR)


//定义PTE的16位端口
#define PTE_W0_OUT        PT_WORD(E,0,PDOR)
#define PTE_W1_OUT        PT_WORD(E,1,PDOR)


//定义PTA的16位输出输入方向端口
#define PTA_W0_DDR        PT_WORD(A,0,PDDR)
#define PTA_W1_DDR        PT_WORD(A,1,PDDR)

//定义PTB的16位输出输入方向端口
#define PTB_W0_DDR        PT_WORD(B,0,PDDR)
#define PTB_W1_DDR        PT_WORD(B,1,PDDR)

//定义PTC的16位输出输入方向端口
#define PTC_W0_DDR        PT_WORD(C,0,PDDR)
#define PTC_W1_DDR        PT_WORD(C,1,PDDR)


//定义PTD的16位输出输入方向端口
#define PTD_W0_DDR        PT_WORD(D,0,PDDR)
#define PTD_W1_DDR        PT_WORD(D,1,PDDR)


//定义PTE的16位输出输入方向端口
#define PTE_W0_DDR        PT_WORD(E,0,PDDR)
#define PTE_W1_DDR        PT_WORD(E,1,PDDR)



//定义PTA的16位输入端口
#define PTA_W0_IN        PT_WORD(A,0,PDIR)
#define PTA_W1_IN        PT_WORD(A,1,PDIR)

//定义PTB的16位输入端口
#define PTB_W0_IN        PT_WORD(B,0,PDIR)
#define PTB_W1_IN        PT_WORD(B,1,PDIR)

//定义PTC的16位输入端口
#define PTC_W0_IN        PT_WORD(C,0,PDIR)
#define PTC_W1_IN        PT_WORD(C,1,PDIR)


//定义PTD的16位输入端口
#define PTD_W0_IN        PT_WORD(D,0,PDIR)
#define PTD_W1_IN        PT_WORD(D,1,PDIR)


//定义PTE的16位输入端口
#define PTE_W0_IN        PT_WORD(E,0,PDIR)
#define PTE_W1_IN        PT_WORD(E,1,PDIR)


//定义PTA的16位输出反转
#define PTA_W0_T        PT_WORD(A,0,PTOR)
#define PTA_W1_T        PT_WORD(A,1,PTOR)

//定义PTB的16位输出反转
#define PTB_W0_T        PT_WORD(B,0,PTOR)
#define PTB_W1_T        PT_WORD(B,1,PTOR)

//定义PTC的16位输出反转
#define PTC_W0_T        PT_WORD(C,0,PTOR)
#define PTC_W1_T        PT_WORD(C,1,PTOR)


//定义PTD的16位输出反转
#define PTD_W0_T        PT_WORD(D,0,PTOR)
#define PTD_W1_T        PT_WORD(D,1,PTOR)


//定义PTE的16位输出反转
#define PTE_W0_T        PT_WORD(E,0,PTOR)
#define PTE_W1_T        PT_WORD(E,1,PTOR)


//定义32位端口输出
#define PTA_OUT          PT_DWORD(A,PDOR)
#define PTB_OUT          PT_DWORD(B,PDOR)
#define PTC_OUT          PT_DWORD(C,PDOR)
#define PTD_OUT          PT_DWORD(D,PDOR)
#define PTE_OUT          PT_DWORD(E,PDOR)

//定义32位端口输入
#define PTA_IN          PT_DWORD(A,PDIR)
#define PTB_IN          PT_DWORD(B,PDIR)
#define PTC_IN          PT_DWORD(C,PDIR)
#define PTD_IN          PT_DWORD(D,PDIR)
#define PTE_IN          PT_DWORD(E,PDIR)

//定义32位端口输出输出方向
#define PTA_DDR          PT_DWORD(A,PDDR)
#define PTB_DDR          PT_DWORD(B,PDDR)
#define PTC_DDR          PT_DWORD(C,PDDR)
#define PTD_DDR          PT_DWORD(D,PDDR)
#define PTE_DDR          PT_DWORD(E,PDDR)

//定义32位输出反转
#define PTA_T          PT_DWORD(A,PTOR)
#define PTB_T          PT_DWORD(B,PTOR)
#define PTC_T          PT_DWORD(C,PTOR)
#define PTD_T          PT_DWORD(D,PTOR)
#define PTE_T          PT_DWORD(E,PTOR)


#endif     //__MK60_GPIO_CFG_H__
