fanxiaohui/SmartCar/十二届光电追逐组程序（附说明，一点资料）/国赛826-A车/Chip/src/MK60_can.c

/*!
 *     COPYRIGHT NOTICE
 *     Copyright (c) 2013,山外科技
 *     All rights reserved.
 *     技术讨论：山外论坛 http://www.vcan123.com
 *
 *     除注明出处外，以下所有内容版权均属山外科技所有，未经允许，不得用于商业用途，
 *     修改内容时必须保留山外科技的版权声明。
 *
 * @file       MK60_can.c
 * @brief      CAN函数
 * @author     山外科技
 * @version    v5.1
 * @date       2014-04-25
 */

#include "common.h"
#include "MK60_port.h"
#include "MK60_can.h"


// CAN ID值越低，报文优先级越高
// CAN 掩码用于屏蔽


// 用于发送缓冲区的报文缓冲区码字
#define CAN_CS_CODE_TX_INACTIVE     B8(1000)            //MB 处于非激活状态
#define CAN_CS_CODE_TX_ABORT        B8(1001)            //MB 被丢弃
#define CAN_CS_CODE_TX_DATA         B8(1100)            //MB 为一个发送数据帧（MB 的 RTR 位为 0）
#define CAN_CS_CODE_TX_REMOTE       B8(1100)            //MB 为一个发送远程请求帧（MB 的 RTR 位为 1）
#define CAN_CS_CODE_TX_TANSWER      B8(1110)            //MB 为是远程请求帧的一个发送回应帧

// 用于接收缓冲区的报文缓冲区码字
#define CAN_CS_CODE_RX_INACTIVE     B8(0000)            //MB 处于非激活状态
#define CAN_CS_CODE_RX_EMPTY        B8(0100)            //MB 激活并且为空
#define CAN_CS_CODE_RX_FULL         B8(0010)            //MB 为满
#define CAN_CS_CODE_RX_OVERRUN      B8(0110)            //写入到一个满缓冲区 导致 MB 被覆盖
#define CAN_CS_CODE_RX_RANSWER      B8(1010)            //一个新帧被配置为确认一个远程请求帧并且发送一个回复帧。
#define CAN_CS_CODE_RX_BUSY         B8(0001)            //正在更新 MB 的内容。CPU 不允许访问MB


CAN_MemMapPtr CANN[] = {CAN0_BASE_PTR, CAN1_BASE_PTR};


//仅适用于CAN时钟源为 50.00MHz
CAN_band_cfg_t can_band_cfg_50000K[CAN_BAUD_MAX] =
{
    //BAND, PRESDIV, PROP_SEG, PSEG1,   PSEG2, RJW
    {10,    624,    4,          0,      0,      0},         //采样点:87.50%
    {20,    124,    12,         2,      2,      2},         //采样点:85.00%
    {50,    124,    4,          0,      0,      0},         //采样点:87.50%
    {100,   24,     12,         2,      2,      2},         //采样点:85.00%
    {125,   24,     10,         1,      1,      1},         //采样点:87.50%
    {250,   24,     4,          0,      0,      0},         //采样点:87.50%
    {500,   4,      12,         2,      2,      2},         //采样点:85.00%
    {1000,  1,      9,          6,      6,      3},         //采样点:72.00%
};
//仅适用于CAN时钟源为 60.00MHz
CAN_band_cfg_t can_band_cfg_60000K[CAN_BAUD_MAX] =
{
    //BAND, PRESDIV, PROP_SEG, PSEG1,   PSEG2, RJW
    {10,    249,    16,         2,      2,      2},		//采样点:87.50%
    {20,    124,    16,         2,      2,      2},		//采样点:87.50%
    {50,    49,     16,         2,      2,      2},		//采样点:87.50%
    {100,   24,     16,         2,      2,      2},		//采样点:87.50%
    {125,   19,     16,         2,      2,      2},		//采样点:87.50%
    {250,   9,      16,         2,      2,      2},		//采样点:87.50%
    {500,   4,      16,         2,      2,      2},		//采样点:87.50%
    {1000,  2,      8,          4,      4,      3},		//采样点:75.00%
};

/*!
 *  @brief      CAN 初始化
 *  @param      CANn_e          CAN 模块号
 *  @param      CAN_BAUD_e      波特率编号
 *  @param      CAN_mode_e      CAN 模式( 正常 、 回环 模式)
 *  @param      CAN_CLKSRC_e    CAN 时钟源( bus 、 外部晶振)
 *  @since      v5.0
 *  Sample usage:       can_init(CAN1,CAN_BAUD_20K,CAN_LOOPBACK);   //初始化 CAN1 ，波特率 20Kb/s ， 回环模式
 */
void can_init(CANn_e cann, CAN_BAUD_e band, CAN_mode_e mode,CAN_CLKSRC_e clksrc)
{
    uint8 i;
    CAN_MemMapPtr canptr = CANN[cann];

    switch(cann)
    {
    case CAN0:
        SIM_SCGC6 |= SIM_SCGC6_FLEXCAN0_MASK ;                  //开启 CAN0 时钟
        port_init(CAN0_TX_PIN, ALT2);
        port_init(CAN0_RX_PIN, ALT2);
        break;
    case CAN1:
        SIM_SCGC3 |= SIM_SCGC3_FLEXCAN1_MASK;                   //开启 CAN1 时钟
        port_init(CAN1_TX_PIN, ALT2);
        port_init(CAN1_RX_PIN, ALT2);
        break;
    default:
        ASSERT(0);                                              //断言，cann值有误？
    }

    //选择时钟源
    if(clksrc == CAN_CLKSRC_BUS)
    {
        CAN_CTRL1_REG(canptr)   |= CAN_CTRL1_CLKSRC_MASK;           //选择为bus 时钟
    }
    else
    {
#if defined(MK60DZ10)
        OSC_CR |= OSC_CR_ERCLKEN_MASK;                              //使能 OSCERCLK
#elif  defined(MK60F15)
        OSC0_CR |= OSC_CR_ERCLKEN_MASK;                              //使能 OSCERCLK
#endif
        CAN_CTRL1_REG(canptr)   &= ~CAN_CTRL1_CLKSRC_MASK;
    }

    CAN_MCR_REG(canptr) &= ~CAN_MCR_MDIS_MASK;                  //使能CAN模块

    CAN_MCR_REG(canptr) |=  CAN_MCR_FRZ_MASK;                   //使能冻结模式

    while((CAN_MCR_REG(canptr) & CAN_MCR_LPMACK_MASK ));        //等待复位（低功耗模式无法复位成功）

    CAN_MCR_REG(canptr) |= CAN_MCR_SOFTRST_MASK;                //软件复位

    while(!(CAN_MCR_REG(canptr) & CAN_MCR_FRZACK_MASK));        //等待进入冻结模式

    //清空邮箱缓冲区内容清0
    i = 16;
    while(i)
    {
        i--;
        CAN_CS_REG(canptr, i) = 0;
        CAN_ID_REG(canptr, i) = 0;
        CAN_WORD0_REG(canptr, i) = 0;
        CAN_WORD1_REG(canptr, i) = 0;
    }

    CAN_CTRL2_REG(canptr) = (0
                             //| CAN_CTRL2_EACEN_MASK            //接收邮箱过滤IDE匹配，RTR不匹配
                             //| CAN_CTRL2_RRS_MASK              //不自动产生远程请求帧
                             //| CAN_CTRL2_MRP_MASK              //邮箱首先从接收FIFO队列匹配然后再在邮箱中匹配
                             | CAN_CTRL2_TASD(22)                //Tx Arbitration Start Delay
                            );

    //使用一个32位过滤器
    CAN_MCR_REG(canptr) = (CAN_MCR_REG(canptr) & (~CAN_MCR_IDAM_MASK)) | CAN_MCR_IDAM(0);

    //设置波特率
    can_setband(cann, band);

    //回环模式
    if(mode == CAN_LOOPBACK)
    {
        CAN_CTRL1_REG(canptr) |= CAN_CTRL1_LPB_MASK;//使用回环模式
    }

    //默认使用 独立 掩码
    CAN_MCR_REG(canptr) |= CAN_MCR_IRMQ_MASK;

    //初始化掩码寄存器
    i = NUMBER_OF_MB;
    while(i)
    {
        i--;
        CAN_RXIMR_REG(canptr, i) = 0x0;
    }

    CAN_RXMGMASK_REG(canptr) = 0x0;
    CAN_RX14MASK_REG(canptr) = 0x0;
    CAN_RX15MASK_REG(canptr) = 0x0;

    //只有在冻结模式下才能配置 配置完退出冻结模式
    CAN_MCR_REG(canptr) &= ~(CAN_MCR_HALT_MASK);

    //等待模块推出冻结模式
    while( CAN_MCR_REG(canptr) & CAN_MCR_FRZACK_MASK);

    //等待同步
    //等到不在冻结模式，休眠模式或者停止模式
    while(CAN_MCR_REG(canptr) & CAN_MCR_NOTRDY_MASK);
}
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
