fanxiaohui/SmartCar/(commit log)

2018-02-07 User文件上传
2018-02-07 野火外设代码
2018-02-07 野火k60库
2018-02-07 工程文件
2018-02-07 删除临时文件
2018-02-07 第十二届光电追逐组程序
2018-02-07 PCB资料
    [A车主板模版.PcbDoc, A车卧式舵机支架.PcbDoc, A车模连接板1型.PcbDoc, A车模连接板2型.PcbDoc, LQ_KXXP144-SYSVGPCB.PCBLIB, LQ_KXXP144-SYSVGSCH.SCHLIB, mini编码器固定板1型.PcbDoc, mini编码器固定板2型.PcbDoc]
2018-03-16 封装完毕并且开始磨轮胎/蓝牙测速模式
    Image_Process.c/h 图像处理
