fanxiaohui/SmartCar/(notices)

Notices in the files:
十二届光电追逐组程序（附说明，一点资料）/国赛826-A车/Chip/inc/common.h:
Copyright (c) 2013,É½Íâ¿Æ¼¼
All rights reserved.
